nvanhand/ME6705/README.md

# Introduction 
A touch probe is a ubiquitous tool found in many manual and CNC machines which is essential for accurate measurements. A touch probe aids in coordinating the machine origin to the physical part, and can help find the zero coordinate position in multiple axes. At the simplest end of the spectrum, CNC touch probes can be a simple spring which, when offset, can visually indicate that the edge of a workpiece has been contacted, at which point the machinist can manually zero the coordinates. More complex probes utilize a conductive tip that relays an impulse to a controller. Based on the preset tool offsets, the system can automatically set the recorded coordinate as the new zero. 

At the GT Advanced Manufacturing Pilot Facility (AMPF) many machines are outfitted with automatic touch probes. Machines like the Mazak VCU-500AM utilize a Renishaw probe which functions using a Renishaw tool cycle in order to control the touch probe and set new relative coordinates. However, other machines, such as the facility's Okuma Armoid, has no probe tool. The machine of interest is a standard CNC lathe and thus only requires the touching off of the Z (axial) and R (radial) directions. 

In order to address this need, Team 1 has chosen to model a 1D Touch probe system using the myRio microcontroller. The resulting insights and hardware will be later utilized for the Okuma system. In the proposed system, the machine is simulated with a motor and the coordinate logic is programmed in LabView. 

# Requirements
## Table of Requirements

| Category | No. | Threshold/Objective* | Requirement | Value | Unit |
| :---: | --- | :---: | --- | ----- | ---- |
| Interface | 1 | T | Users shall interface with the prototype via a LabView front panel. | T/F |  |
| | 2 | T | Interface will permit the activation of the measurement routine. | T/F |  |
| | 3 | T | Interface should update with the measured distance value. | T/F |  |
| | 4 | O | System will provide debug logs to the interface. | T/F |  |
| Measurement/Data Capture | 5 | T | Measurement accuracy | 1 | mm |
| | 6 | O | Measurement accuracy | 0.1 | mm |
| | 7 | T | System uncertainty should be quantified and reported. | T/F |  |
| | 8 | O | Measurement repeatability | 0.1 | mm |
| | 9 | T | Measurement repeatability | 0.01 | mm |
| Wireless | 10 | O | Quantify and report system latency | 1 | s |
| | 11 | T | System connects to laptop without a wired connection | T/F |  |
| Feedback | 12 | O | Have an external light to indicate Myrio power | T/F |  |
| | 13 | T | System should alert the user when contact is made with the probe during measurement. | T/F |  |
| Weight/Dimensions | 14 | 0 | Touch probe weight | 1 | lb |
| | 15 | O | Touch probe width/length | (4,6) | inch |
| | 16 | O | Touch probe length | (4,6) | inch |
| | 17 | O | Probe travel distance | <10 | inch |
| Power | 18 | T | Prototype shall operate for 1 hour without the need to change batteries | 1 | hour |
| | 19 | O | Prototype shall have "idle" mode that can run without a significant power loss. | T/F |  |
| | 20 | O | Prototype shall operate for 4 hours without the need to change batteries | $4+$ | hour |
| Quality Control | 21 | T | Number of system bugs detected upon prototype demonstration | $<5$ | bugs |
| | 22 | O | Number of system bugs detected upon prototype demonstration | 0 | bugs |
| | 23 | T | Project professionalism | Scale: $1-10$ |  |
| Project requirements | 24 | T | Prototype uses LabVIEW | T/F |  |
| | 25 | T | Prototype uses the myRIO | T/F |  |
| | 26 | T | Prototype uses $2+$ actors | T/F |  |
| | 27 | O | Prototype uses a minimum of 2 actors to perform a meaningful, complex system. | T/F |  |
| | 28 | T | Prototype uses $2+$ sensors | T/F |  |
| | 29 | O | Prototype uses a minimum of 2 sensors of sufficient complexity.  | T/F |  |
| | 30 | T | Prototype design/assembly is unique (i.e., not found from a brief Google search) | T/F |  |
| | 31 | O | Prototype creativity/uniqueness, as determined by the customer (Dr. Noel) | Scale: $1-10$ |  |
| | 32 | T | Prototype uses at least 1 advanced mechatronics concept | T/F |  |
| | 33 | O | Prototype goes above and beyond with exploring advanced mechatronics concept | T/F |  |

## Discussion 
The previous section will be discussed in further depth in this section. 

### Project Requirements, Quality Control
The project and quality control requirements were provided by the ME 6705 instructor and TAs. The requirements were defined to display basic mastery of the course material, requiring meaningful sensors and actors for the prototype. The designed system utilizes the following sensors and actors:

| | | Purpose |
|---|---|---|
| Actor 1 | Stepper Motor | Drive measurement probe forward. |
| Actor 2 | Buzzer | Audibly indicate when a measurement has been made. |
| Sensor 1 | Encoder | Accurately measure sensor position. |
| Sensor 2 | Limit switch | Indicate when the touch probe has made contact. |

### Power
Power requirements were designed not as threshold characteristics but "nice-to-have" objectives which indicate success as a probe. Touch probes are typically powered externally to the machine via batteries, as the prototype will be. However, the prototype's battery life is expeceted to be much shorter than a typical probe, as the entire assembly must be powered rather than just the probe. 

### Weight/Dimensions
The only requirements for the physical system involve the probe head, as the remainder is simply a simulation of a real system. The probe should be 
compact and of a size compatible with Okuma tool holders. Generic measurements were chosen based on a reasonable size and travel distance. 

### Feedback
At a minimum, there should be an obvious indication when a measurement has been taken. The proposed design utilizes a buzzer to indicate a completed measurement, similar to the sound made by Renishaw probes. 

### Wireless
Related to project requirements, the system should function without physical connection to the controlling laptop. Ideas for extensions of this domain were: automated IP detection, measuring limits on wireless communication based on reason, HTTPs functionality. 

### Measurement Capture
For any touch probe system, measurement capability is an important metric to quantify and report with any product. In all cases, the highest possible accuracy and measurement repeatibility is ideal, however, reasonable thresholds have been set in order to prove out the system. 

# State Machine


# Project Demo 
## Front Panel
In the figure, the front panel is shown. The X bar acts as both an indicator and control. During "Free" mode, the user can dictate the position of the sensor. When the "Measure" button is pressed, the "X" bar becomes read-only and matches the recorded value. The "Saved Measurement" reads the last value that was measured by measurement mode. 


## LabView 

Some of the code from the Measurement Routine is shown in the following figure. The measurement routine is a sequence diagram. During the sequence, the motor is driven until the "limit switch" button is manually toggled or the limit switch senses contact. 
Measure Routine

## Demo Video 
Video 1: https://photos.app.goo.gl/zQzwp5QSm175Lv2G8
Video 2: https://photos.app.goo.gl/qA9P3V56hwaFqnu39 

# Challenges
While much of the Labview was built on the foundation that had been developed in class, there were many learning opportunities in the prototype assembly. 
### Wireless Connection
As no wireless connectivity was covered in class, Team 1 needed to learn how to connect the myRio wirelessly. The local reference files on Labview were referenced to begin this process. Issues were had when trying to replicate this on campus, as the Mechatronics lab computers prevented network configuration due to lack of administrative permissions. Additionally, configuring wireless devices on the primarily eduroam network was prohibited, so permissions were attempted to be configured over GTOther, the network designed for this end. However, getting a password to connect to the network first requires an initial connection to the GTOther network. Ultimately, Team 1 decided to only demonstrate the prototype on a home network to circumvent further IT related issues. 

### Mechanical Assembly
To drive the probe tip and compute distance travelled, a mechanical assembly was necessary. In order to track the distance travelled, the motor encoder assembly was connected to a lead screw. The motor would turn the screw, driving any attachments forward such as a block that came with the system. However, when mounted onto a board, the friction caused difficulty, requiring the metal block to be faced. 

To connect the motor to the , a custom shaft coupling had to be manufactured to fit the motor to the lead screw assembly. 

The limit switch had a significant deflection distance required to register contact. Thus, the roller arm had to be mounted to decrease this difference, and the deflection had to be accounted for in the calculated measurement. Additionally, the actuation of the limit switch was initially too significant for the motor to reasonably accomplish. The mechanical assembly had to be modified to lessen the force required for switching. 

### Assembly Stability
While the system itself was functional, a substantial challenge was in creating an even surface to test. The Plywood that was chosen to mount the lead screw lacked evenness and weight, which made external weight required when testing, as the motor-limit switch force was able to move the entire assembly during contact. Addditionally, because the lead screw block had been faced, a small amount of rotational freedom allowed the block to spin before stopping. While not significant, this slight shift caused a non-trivial amount of rotation of the probe arm. This may cause unforseen error depending on the geometry of the measured object.  

### Measurement Validation 
Finally, a significant challenge was the actual validation process. While the project objectives may have had sub-milimeter goals in accuracy, the tools available made it difficult to validate at such a small distance. While calipers could be used to verify short distances, moving the probe along the extent of the X-space required using a system which had measurement in the milimeters such as a tape measure or ruler. 

### Latency 
It was desired to understand the system latency. We define latency in two ways: (1) Network latency, the amount of time required for device communication between the computer and the myRio, (2) Measurement latency, the amount of time between initiating the "measurement action" and the measurement actually being taken. 

For network latency, we may simply ping the myRio address as shown in the figure. We may observe that the average latency is 6ms. 



To determine measurement latency, we define this to be the time between the limit switch being triggered and the measurement value being recorded. We anticipate that this value will be larger than the network latency, since the time for signals to be sent and received has this delay inherent. We utilized the Tick Count function and found the difference between the measured value at the desired points in the program.  

| Trial Number | Latency (ms) |
|---|---|
| 1 | 13 |
| 2 | 8 |
| 3 | 18 |
| 4 | 17 |
| 5 | 13 |
| 6 | 13 |
| 7 | 13 |
| 8 | 13 |
| 9 | 13 |
| 10 | 13 |
| 11 | 13 |
| 12 | 12 |

The average measurement latency was found to be about 13 ms. 

# Conclusions
## Measurement Validation
To determine accuracy, an object was placed a known distance away from the probe. The system offset and translation was set to accurately reflect this value. Then, objects were placed at multiple distances and measured. The results were as follows. 

| Actual | Measured |
| --- | --- |
| 10 | 11.2033  |
| 15 | 15.861 |
| 20 | 21.0021  |
| 25 | 26.4533  |
| 30 | 30.989 |

Notably, measurements were, in every case, larger than the actual. By remeasuring the offset to be 1mm less, the accuracy is within desired 1mm value. 

To determine repeatibility, the distance of a fixed object was repeatedly measured. The measurements of 5 trials is provided below:

| Trial | Result |
| --- | --- |
| 1 | 33.3913  |
| 2 | 33.1687  |
| 3 | 33.2243  |
| 4 | 33.28 |
| 5 | 33.3357  |

The standard deviation of the process was 0.0787mm, a larger value than the desired, but greater than the threshold value. 

## Lessons Learned and Future Work
Throughout the process of this project, Team 1 learned many lessons about the reality of developing a touch probe system that can be taken to develop a solution for AMPF machinery. The best takeaway was understanding the challenges of having synchronizing the motion system and sensor. Team 1 was able to apply logic that would be replicable in a machine system. Additionally, a better understanding of the iterative design, build, and debug process was gained. A literacy in reading documentation and specing electrical parts will be a valuable tool moving forward. The system as a whole will not be iterating upon in its current form, rather, the lessons will be applied to a new system with a smaller microcontroller. 

While the current system is only unidirectional, a more generalizable solution should be able to probe in at least two dimensions. Addiionally, the current limit switch only probes in the positive direction, while a truly applicable solution should be able to be used from both sides. 

Finally, another direction that was explored but not fully realized in the final system was utilizing HTTPS to interact with the system. While all the setup was done to make use of the Real Time Web Services, following [this tutorial]([this tutorial](https://learn-cf.ni.com/teach/riodevguide/code/rt_web-service-host.html), the functionality was not included in the final VI, as Team 1 did not opt to develop a website which would have made use of this capability. However, this is still a promising direction to pursue for future study.
