nvanhand/ME6705/Team1_FinalSlides.pdf

# ME 6705 Final Project

Team 1: Nikki V. H. and Shohom B.B.

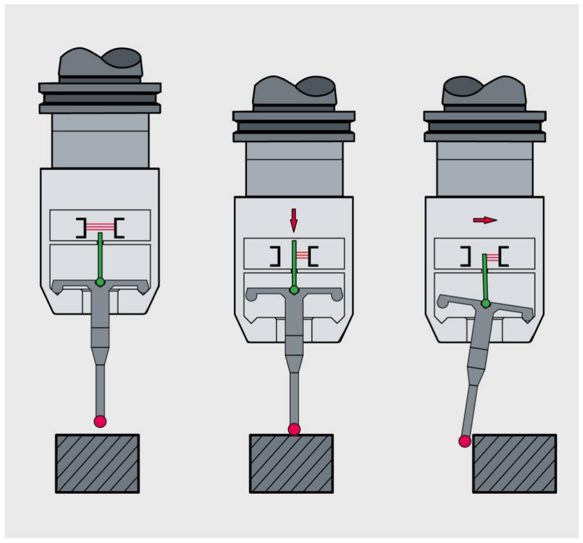
[picture p1: figure]

- A touch probe is a common machine tool used to determine an exact position of stock.
- Motivation: Design and actuate a mechanical system to perform a 1D measurement to simulate a touch probe.

## Goal

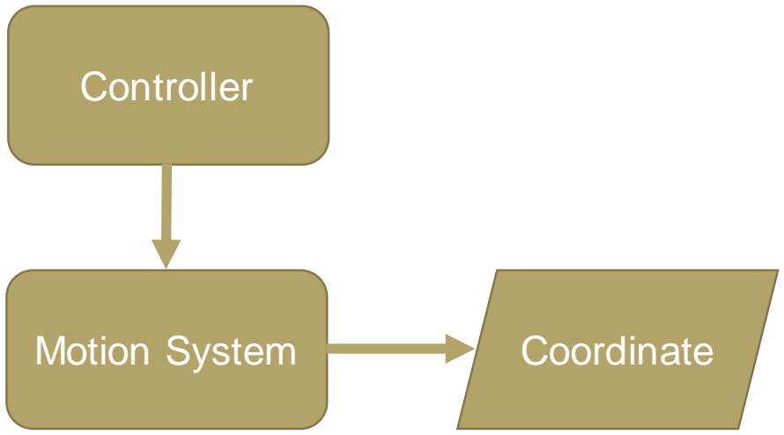
[picture p2: figure]
Controller; Motion System; Coordinate

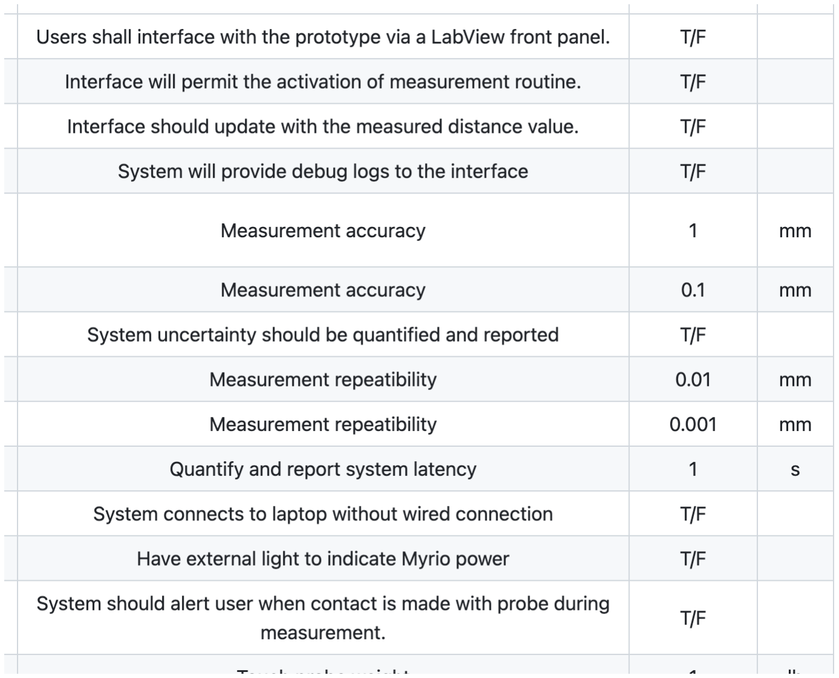
[picture p3: figure]

## Requirements

- Measurement capability
- Wireless connectivity
- Measurement feedback

## Nice-to-haves

- Weight/Dimensions
- Power constraints

## LabView

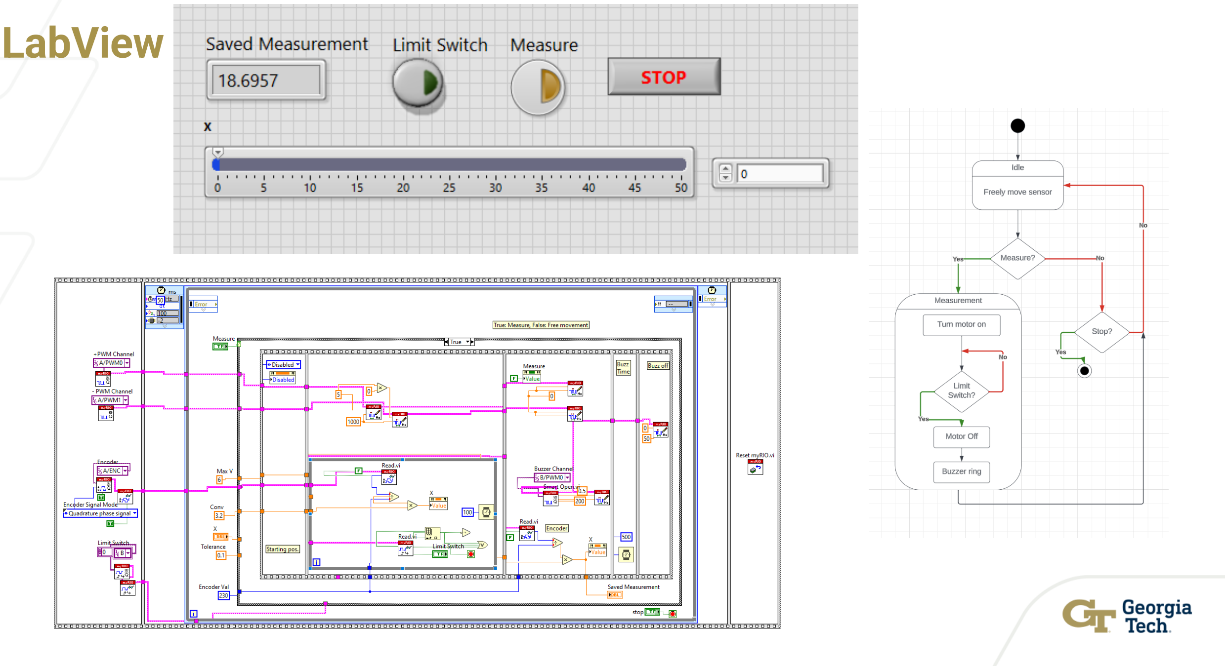
[picture p4: page 4]

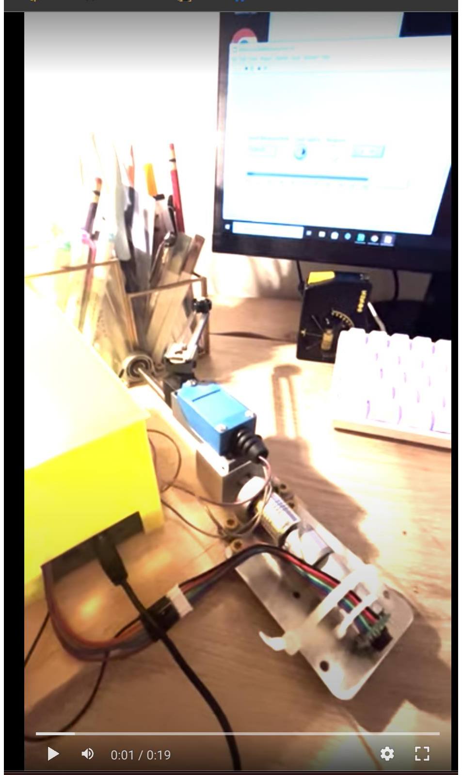
[picture p5: figure]

## Wireless Demo

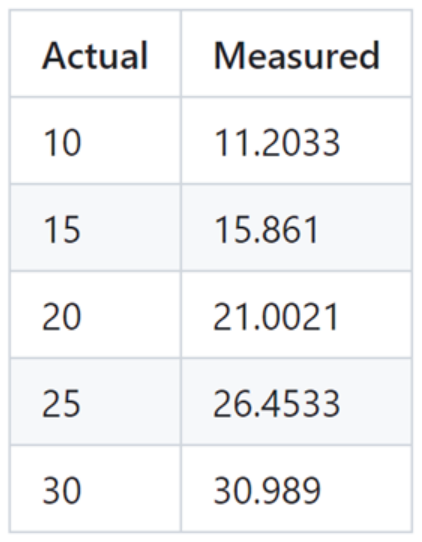
[picture p6: figure]
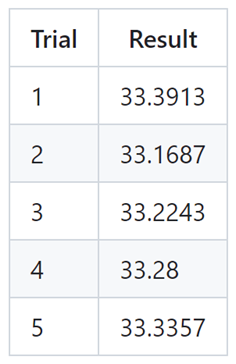
[picture p7: figure]

## Results

Testing for Accuracy and Repeatability
- Accuracy: Varied actual distance and compared measured value
- Approx. 1mm offset
- Repeatability: Remeasured at same distance
- Standard deviation of .0787 mm between each measurement
Accuracy | Repeatibility

## Future Work

## - Redesign system for machine use

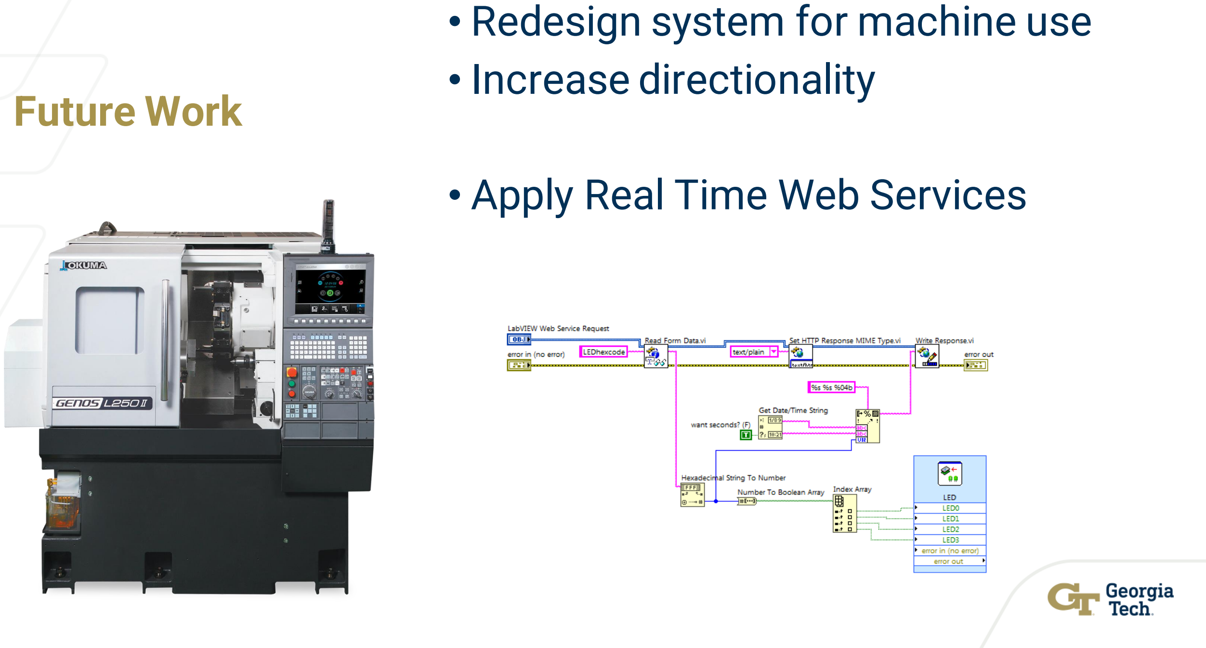
[picture p8: page 7]

## - Increase directionality

## - Apply Real Time Web Services

# Thank you ! Questions ?
