nvanhand/ME6705/Final Project/WheelHub.stl

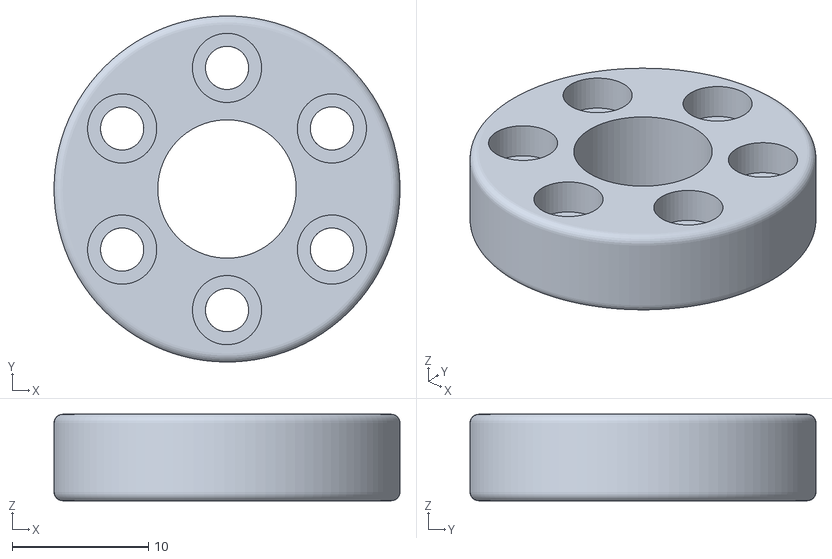
[picture p9: CAD file, 2023-11-29]
Final Project/WheelHub.stl
25.4 x 25.4 x 6.35
