nvanhand/ME6705/(list of files, cad)

Other CAD files:
Final Project/WheelHub.f3d
