nvanhand/ME6705/Final Project/Setup.md

# Remote Setup
1. Open NI Max. Under **Remote Systems** open the NI Rio.
3. Right click **Software**. There may be an password check - if there has been no password setup, just click enter. 
Check Application Web Server, DataSocket for LabView Real-Time, HTTP Client with SSL Suppport, I/O Variable Remote Configuration Web Service, and Remote Panel Server for LabVIEW RT if they are available to add. 
4. Ensure LabVIEW Real-Time , Variable Cleient Support for LabView RT, have been added (See remove tab). 
5.
