nvanhand/ME6705/(commit log)

2023-09-28 nikki_working session
    Added temp testing func, all sensors should work
2023-09-28 added all sensors
    sensors work god bless america
2023-09-29 updated gyro
2023-10-04 nested case structure version actual
2023-10-11 Add files via upload
    servo working
2023-10-20 replicated pid
